mendax1234/CG1111A-Final-Project/(commit log)

2024-10-28 Add celebrate and LED
2024-10-29 Add IR sensor
2024-10-31 Add turn degree, blink LED function and improve readability
2024-11-05 IR sensor with ambient light
2024-11-06 Change name for ir_detector functinos since arduino will compile all the sketches under the same folder into a new one
2024-11-08 Update constants and add LED to celebrate
2024-11-12 Update b_navigation.ino with IR correction
    [b_navigation.ino]
2024-11-14 Fix small code erros with previous IR Read
    [d_sensor.ino]
2024-11-17 Seperate the color calibration code
